rahulsarchive/V-slot-Gantry/Images/14.jpeg

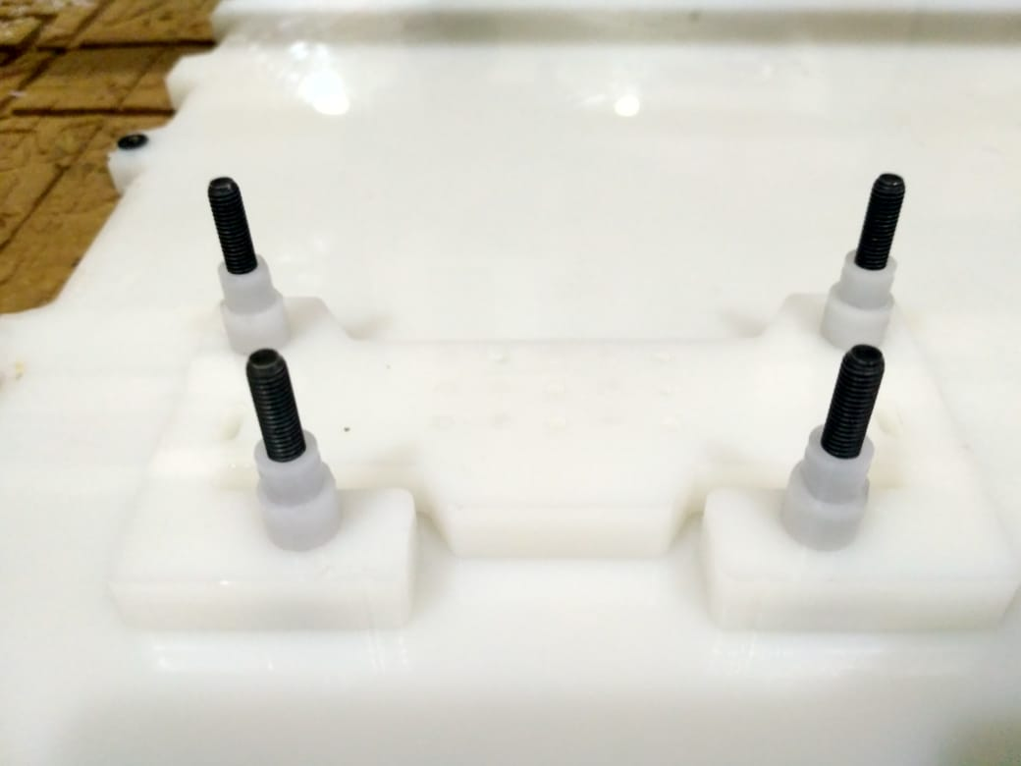
Images/14.jpeg
