rahulsarchive/V-slot-Gantry/Images/.picasaoriginals/15.jpg

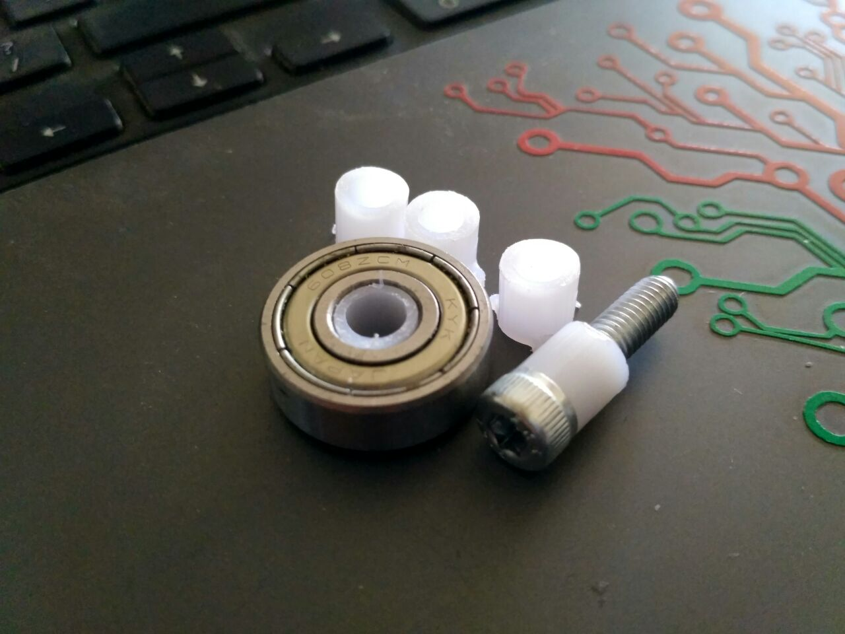
Images/.picasaoriginals/15.jpg
