rahulsarchive/V-slot-Gantry/Images/.picasaoriginals/WhatsApp Image 2019-04-02 at 3.56.16 PM (2).jpeg

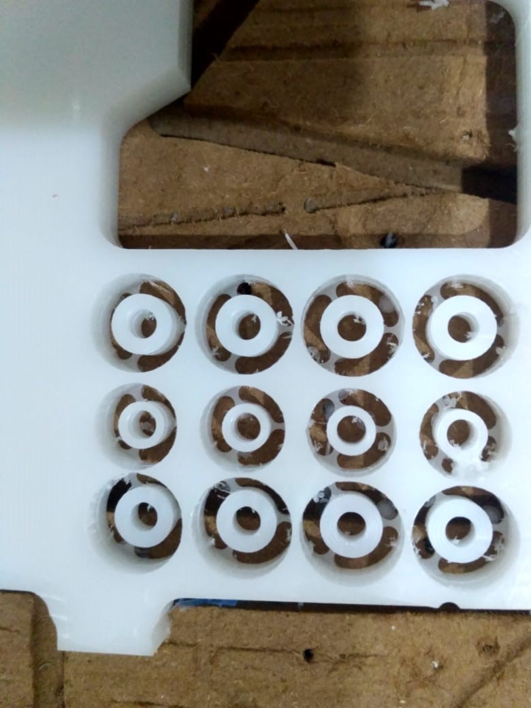
Images/.picasaoriginals/WhatsApp Image 2019-04-02 at 3.56.16 PM (2).jpeg
