rahulsarchive/V-slot-Gantry/Images/.picasaoriginals/WhatsApp Image 2019-04-02 at 3.56.17 PM.jpeg

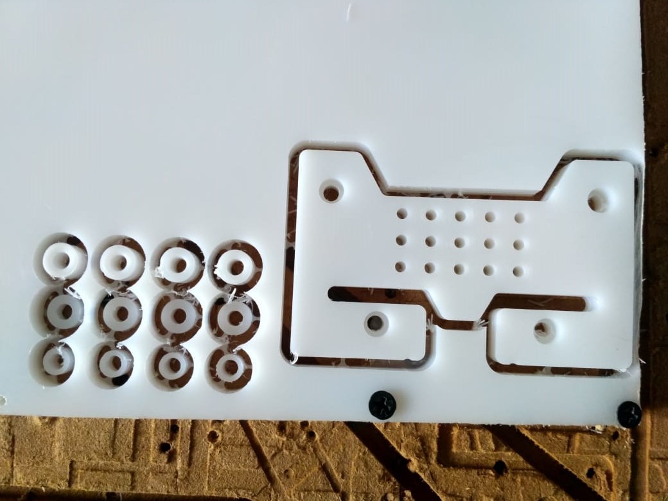
Images/.picasaoriginals/WhatsApp Image 2019-04-02 at 3.56.17 PM.jpeg
