rahulsarchive/V-slot-Gantry/Images/.picasaoriginals/WhatsApp Image 2019-04-02 at 4.00.06 PM (2).jpeg

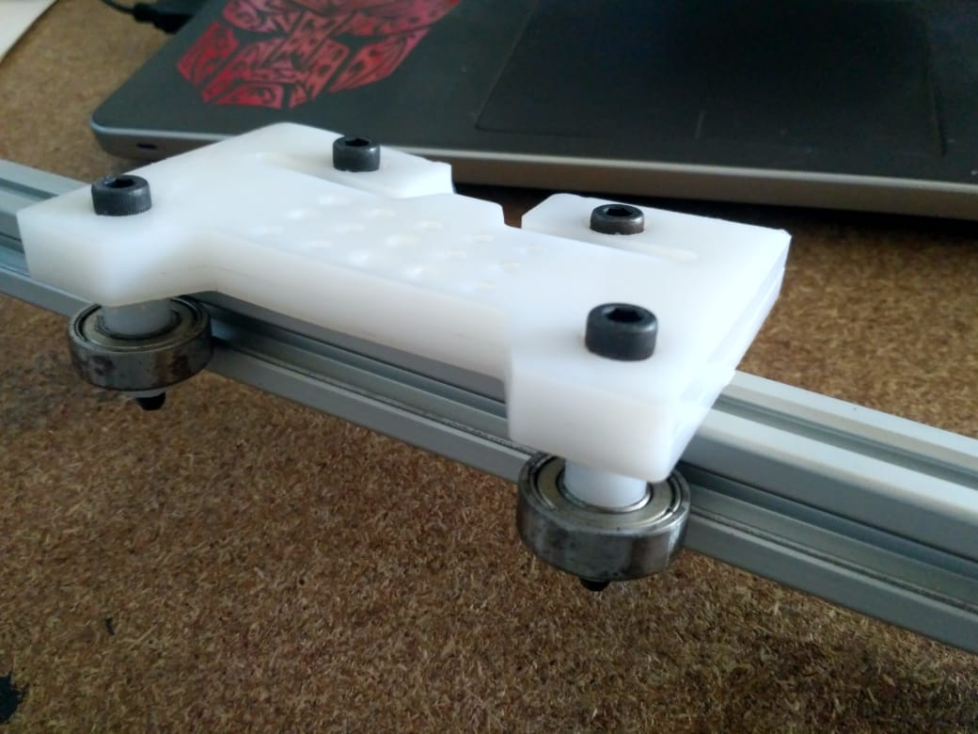
Images/.picasaoriginals/WhatsApp Image 2019-04-02 at 4.00.06 PM (2).jpeg
