rahulsarchive/V-slot-Gantry/Images/.picasaoriginals/WhatsApp Image 2019-04-02 at 4.00.08 PM.jpeg

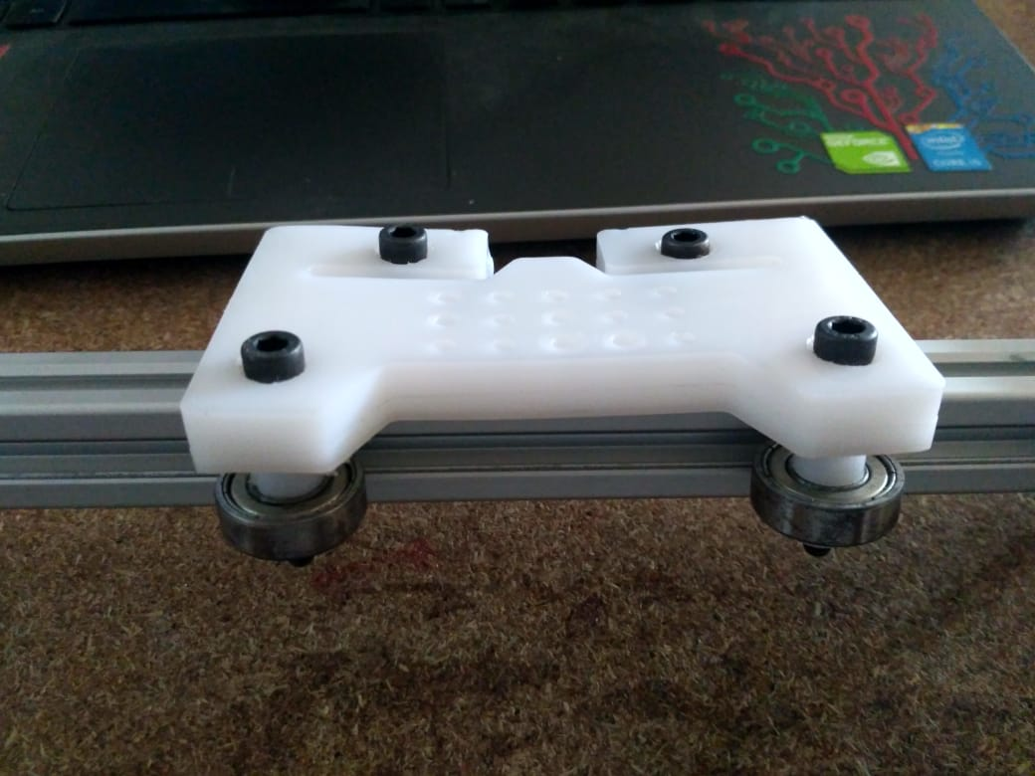
Images/.picasaoriginals/WhatsApp Image 2019-04-02 at 4.00.08 PM.jpeg
