rahulsarchive/V-slot-Gantry/Design Files/5mm end cap.dxf

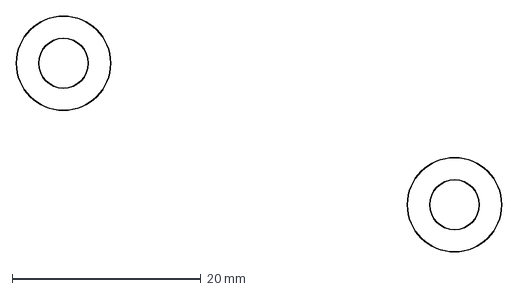
[picture p26: CAD file, 2019-04-02]
Design Files/5mm end cap.dxf
51.5 x 25.0 mm
