rahulsarchive/V-slot-Gantry/Design Files/Bearing wheel.dxf

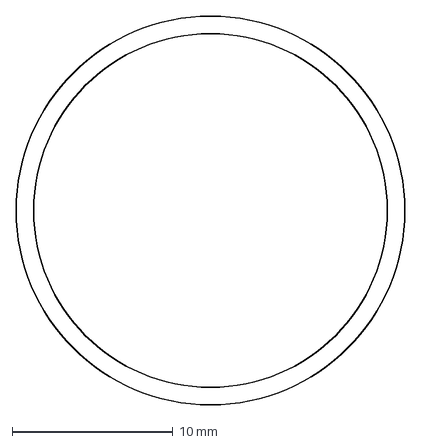
[picture p27: CAD file, 2019-04-02]
Design Files/Bearing wheel.dxf
24.2 x 24.2 mm
