rahulsarchive/V-slot-Gantry/Design Files/Carriage.dxf

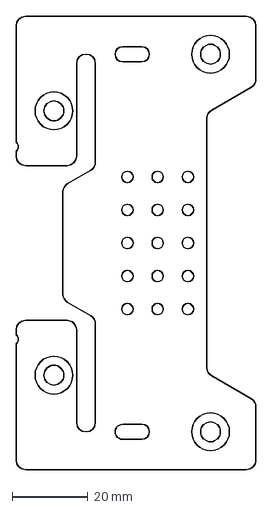
[picture p28: CAD file, 2019-04-02]
Design Files/Carriage.dxf
63.5 x 120.0 mm
