rahulsarchive/V-slot-Gantry/Design Files/8.4mm top spacer.dxf

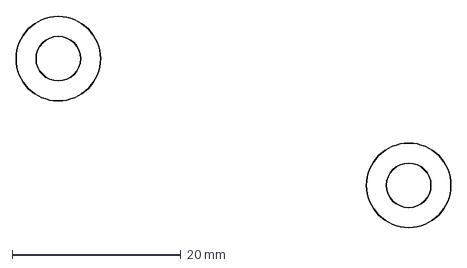
[picture p29: CAD file, 2019-04-02]
Design Files/8.4mm top spacer.dxf
51.5 x 25.0 mm
