rahulsarchive/V-slot-Gantry/Design Files/7mm bearing bush.dxf

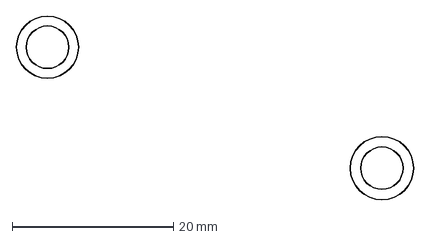
[picture p30: CAD file, 2019-04-02]
Design Files/7mm bearing bush.dxf
49.3 x 22.8 mm
