rahulsarchive/V-slot-Gantry/(list of files, cad)

Other CAD files:
Design Files/10mm Carriage with bushing.3dm
Design Files/V-slot Gantry 2020 v2.f3d
