rahulsarchive/V-slot-Gantry/Images/.picasaoriginals/.picasa.ini

[WhatsApp Image 2019-04-02 at 3.56.17 PM.jpeg]
filters=tilt=1,0.122485,0.000000;crop64=1,2666ffffded9;enhance=1;autolight=1;autocolor=1;
crop=rect64(2666ffffded9)
moddate=383be3184ce9d401
width=1040
height=780
textactive=0
[WhatsApp Image 2019-04-02 at 3.56.16 PM (2).jpeg]
filters=crop64=1,174d5a17ffffd627;
crop=rect64(174d5a17ffffd627)
rotate=rotate(0)
moddate=503051354ce9d401
width=780
height=1040
textactive=0
[WhatsApp Image 2019-04-02 at 3.56.16 PM.jpeg]
filters=crop64=1,4ec303fffffe762;enhance=1;autolight=1;
crop=rect64(4ec303fffffe762)
moddate=faaac76f4ce9d401
width=1040
height=780
textactive=0
[WhatsApp Image 2019-04-02 at 3.56.15 PM.jpeg]
filters=enhance=1;autolight=1;
moddate=6686c95e4ce9d401
width=1040
height=780
textactive=0
[WhatsApp Image 2019-04-02 at 4.00.06 PM.jpeg]
filters=enhance=1;autolight=1;crop64=1,23710bdffffe95a;
moddate=02caa37c4ce9d401
width=1040
height=780
textactive=0
crop=rect64(23710bdffffe95a)
[WhatsApp Image 2019-04-02 at 4.00.06 PM (2).jpeg]
filters=enhance=1;crop64=1,14ade85ee1cd;enhance=1;
crop=rect64(14ade85ee1cd)
moddate=515a9d954ce9d401
width=1040
height=780
textactive=0
[WhatsApp Image 2019-04-02 at 4.00.07 PM (2).jpeg]
filters=crop64=1,123746e4f999fc63;
crop=rect64(123746e4f999fc63)
moddate=d3f60ec24ce9d401
width=1040
height=780
textactive=0
[WhatsApp Image 2019-04-02 at 4.00.08 PM.jpeg]
filters=enhance=1;autolight=1;crop64=1,ec51e86fd4ac834;
crop=rect64(ec51e86fd4ac834)
moddate=376bc4c24ce9d401
width=1040
height=780
textactive=0
[15.jpg]
filters=crop64=1,66612abffffd199;enhance=1;autolight=1;
crop=rect64(66612abffffd199)
moddate=84b984ce4de9d401
width=1280
height=960
textactive=0
